Carine-Jade/Projet-Arduino/README.md

# Projet-Arduino : Arbébéduino
plafonnier animé pour bébé
