Carine-Jade/Projet-Arduino/Morin-séance3_rapport.pdf

06/01/2020
Rapport séance 3 - Jade Morin Projet : Arbébéduino

Objectif de séance : Aujourd’hui je devais finir le programme des moteurs. En effet, le programme de la dernière séance ne permettait pas de faire tourner deux moteurs pas à pas simultanément. Mon objectif était donc d’utiliser la bibliothèque AccelStepper.

Différence entre la bibliothèque AccelStepper et Stepper : En lisant les forums, je me suis rendue compte que si je voulais faire tourner plusieurs moteurs avec un seul programme il fallait utiliser la bibliothèque AccelStepper qui est une bibliothèque non bloquante contrairement à Stepper.

En TD je suis donc arrivée aux programmes suivants :
Version 1 du voidloop():

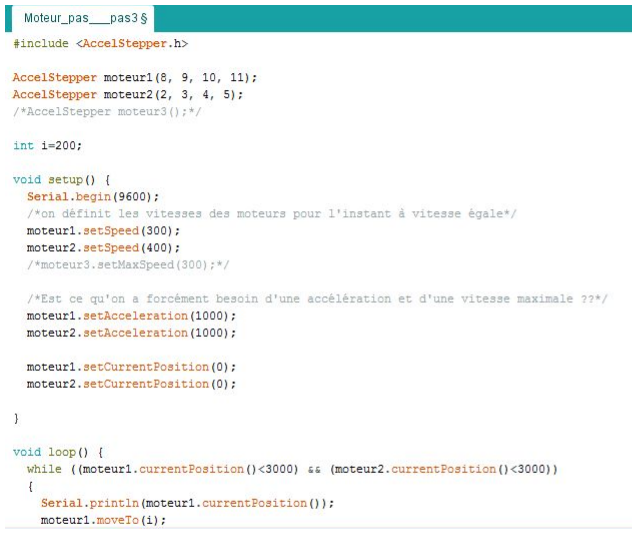
[picture p43: figure]

Version 2 du voidloop():

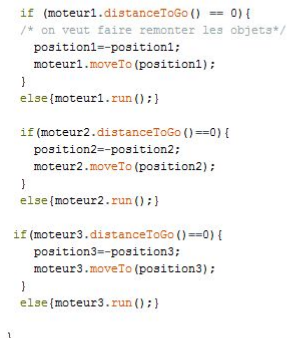
[picture p44: figure]

Dans les deux cas l’aspect non bloquant de la bibliothèque AccelStepper devait permettre à mes 3 moteurs de fonctionner simultanément. Mais ce n’est pas le résultat que j’ai obtenu, en effet, un des moteurs tournait comme il fallait (en faisant le bon nombre de bas etc) alors que le deuxième moteur semblait vibrer sur place. Il n’arrivait pas à faire les pas que le programme lui demandait.

Après vérification des branchements et du bon fonctionnement des moteurs indépendamment l’un de l’autre, vous êtes arrivés à la conclusion que la bibliothèque AccelStepper n’était pas capable de supporter deux moteurs. Autrement dit, on ne peut pas fournir suffisamment d’alimentation pour que les deux moteurs tournent en même temps.

Vous vous êtes donc retournés vers la bibliothèque Stepper en faisant une boucle for, pour que les deux moteurs tournent ensembles. On a donc obtenu le programme suivant :

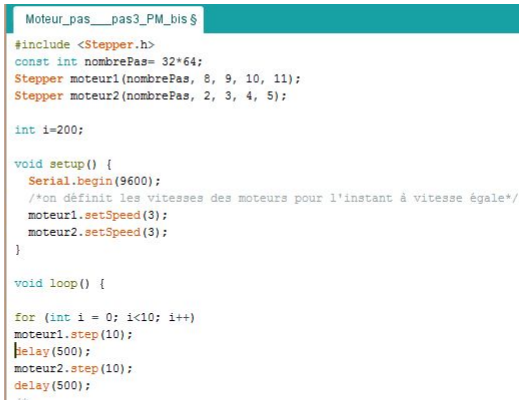
[picture p45: figure]

Cependant même problème que précédemment, certes les deux moteurs tournent simultanément, mais un seul parvient à suivre le rythme, le deuxième reste bloqué en vibrant.

Après tous ces essais sans résultats concluant vous m’avez donc conseillé de reprendre le modèle du programme que vous aviez mis en ligne. Ainsi je ne devais plus être embêtée par une bibliothèque car votre programme commandait uniquement les moteurs à faire un pas puis l’autre grâce à une boucle for.
Donc en faisant faire à chacun de mes moteurs 1 pas dans ma boucle for, je devrais parvenir à les faire tourner “simultanément”.
En réalité, l’enchaînement de la boucle for se fait si rapidement que l’on ne voit pas que les moteurs ne tournent pas parfaitement ensembles.

J’ai donc obtenu le début de programme Moteur_pas__pas3_pm que je mets en ligne sur le Github. Je le terminerais pour l’oral. Pour l’instant la partie que j’ai codé permet de faire tourner les moteurs 1 et 2 dans des sens contraire et pour 10 pas.

A faire avant la prochaine séance: Je vais donc devoir coder les pas du troisième moteur, faire “descendre” 2 moteurs sur 3 puis les faire “remonter”. Il me faut donc écrire une deuxième boucle for.
