Carine-Jade/Projet-Arduino/Programme - Application Bluetooth.PNG

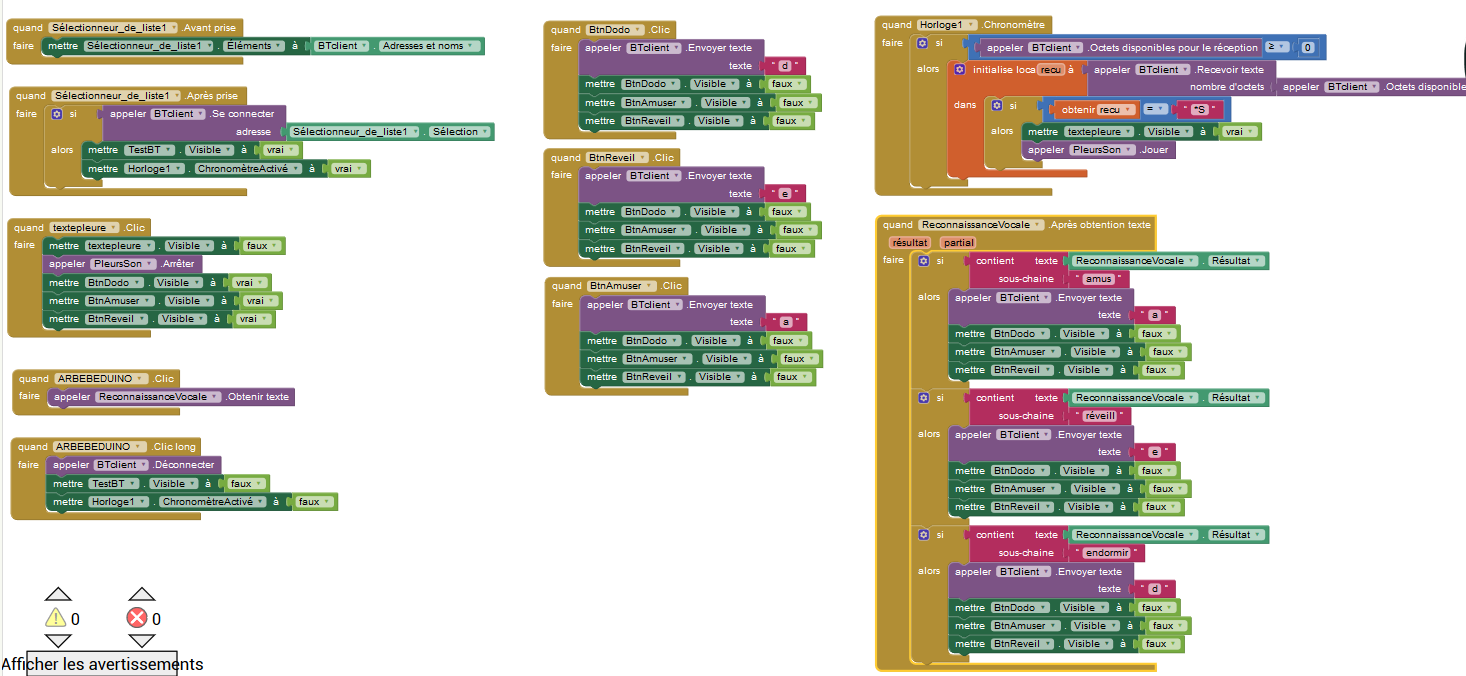
Programme - Application Bluetooth.PNG
