Carine-Jade/Projet-Arduino/Diagramme de Gant (Planning).pdf

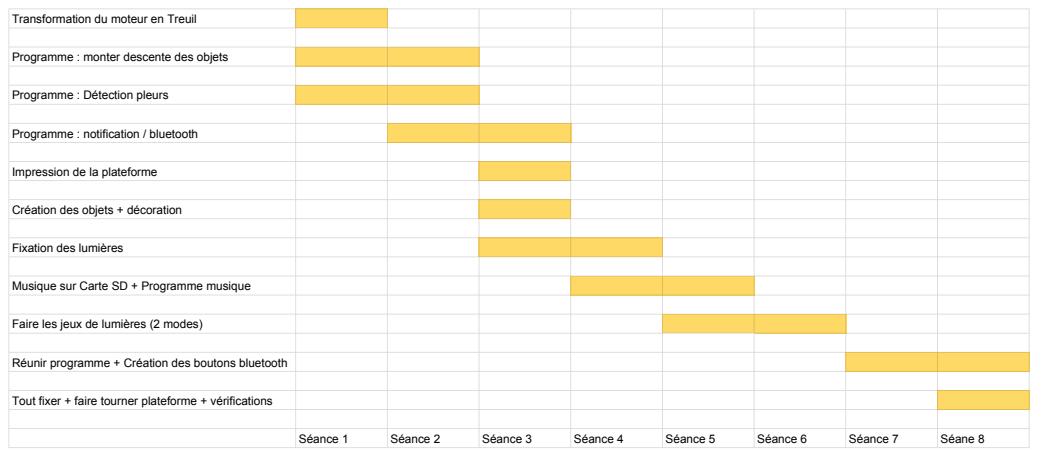
[picture p68: page 1]
Séance 1; Séance 2; Séance 3; Séance 4; Séance 5; Séance 6; Séance 7; Séane 8

Transformation du moteur en Treuil

Programme : monter descente des objets

Programme : Détection pleurs

Programme : notification / bluetooth

Impression de la plateforme

Création des objets + décoration

Fixation des lumières

Musique sur Carte SD + Programme musique

Faire les jeux de lumières (2 modes)

Réunir programme + Création des boutons bluetooth

Tout fixer + faire tourner plateforme + vérifications
